carbuncle01/kart_bridge_board/docs/assets/generated/jpbb_rev2_top_render.png

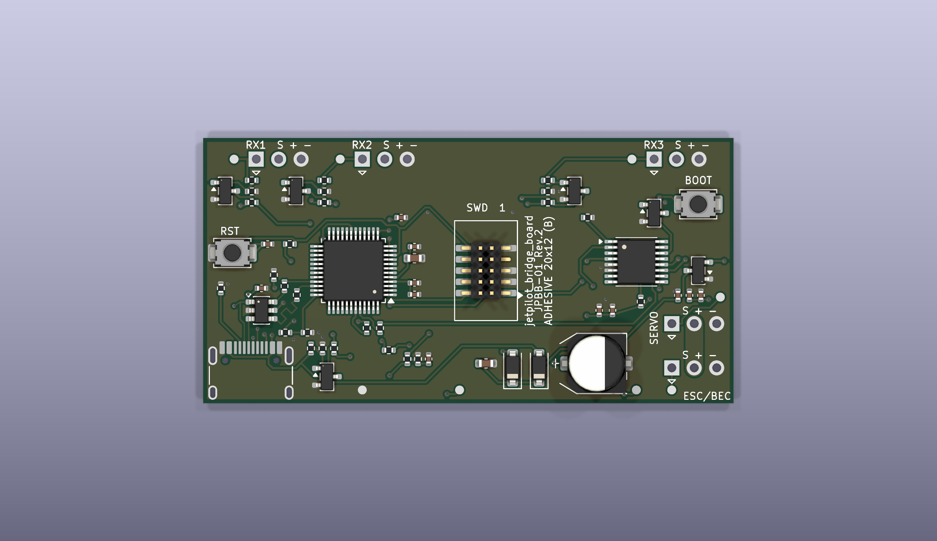
docs/assets/generated/jpbb_rev2_top_render.png
