carbuncle01/kart_bridge_board/docs/assets/jpbb_rev2_component_map.png

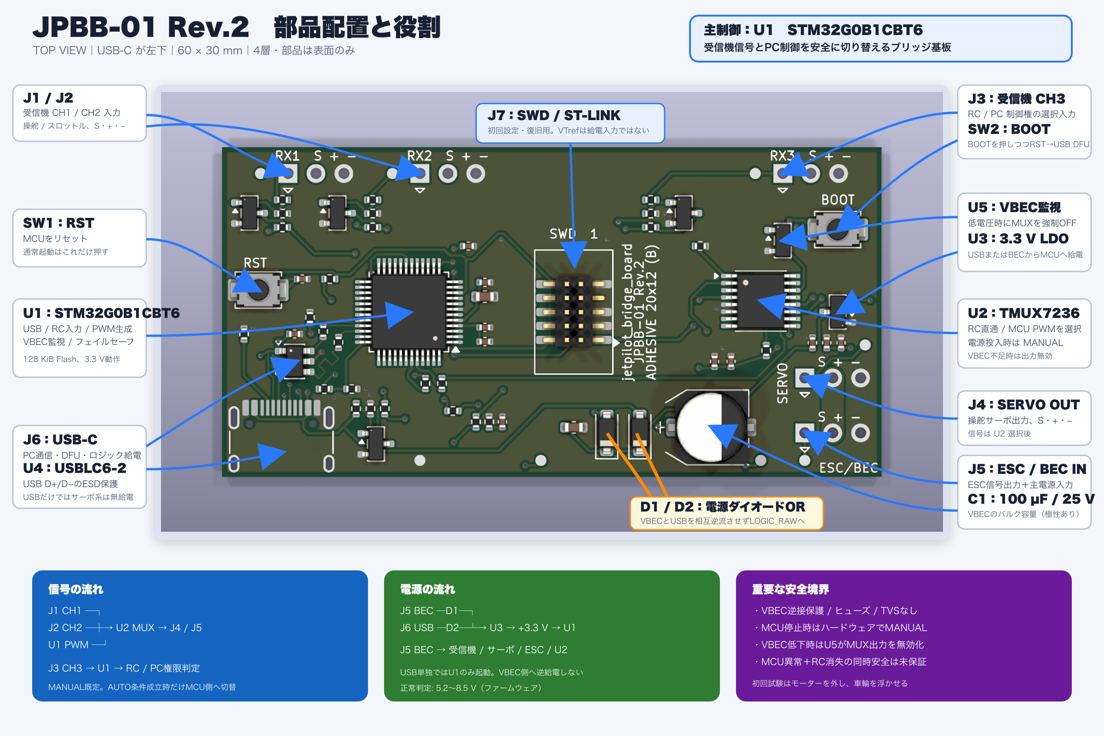
docs/assets/jpbb_rev2_component_map.png
