carbuncle01/kart_bridge_board/docs/assets/jpbb_rev2_testpoint_guide.png

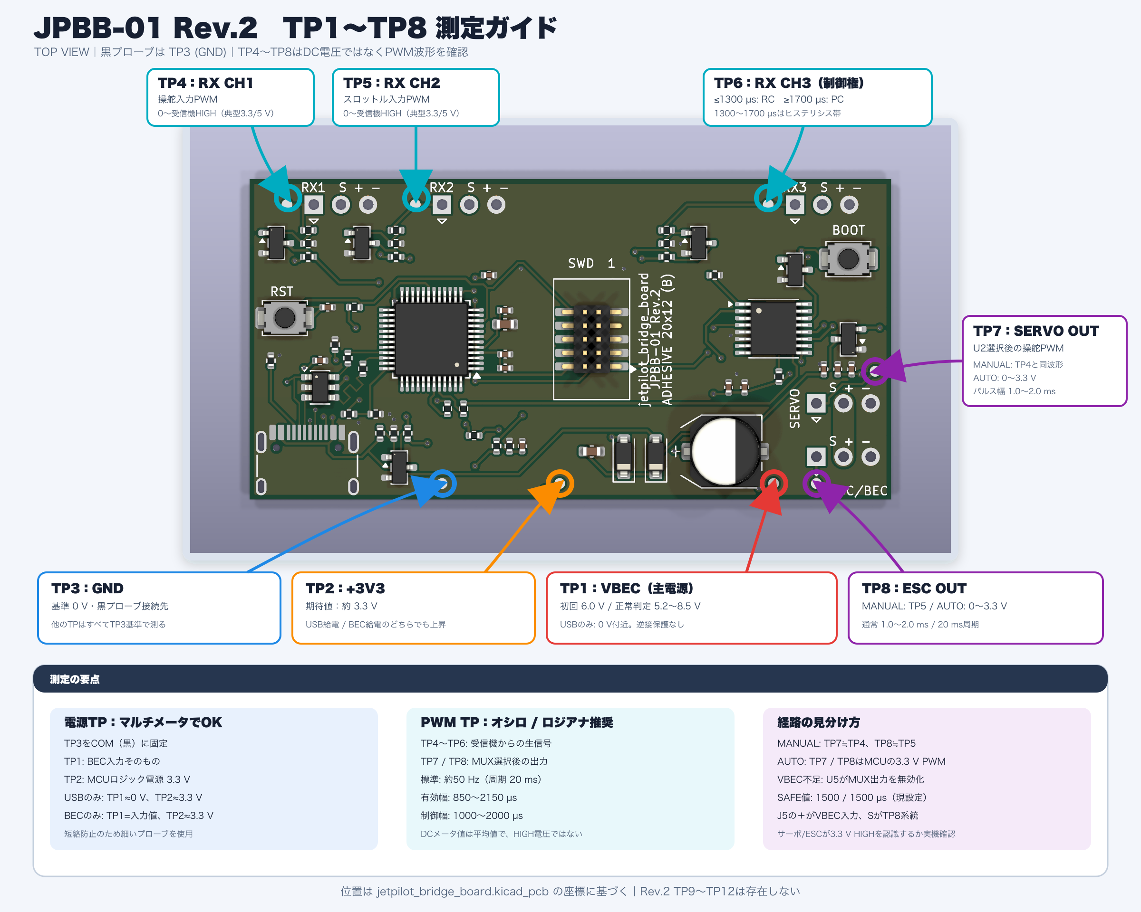
docs/assets/jpbb_rev2_testpoint_guide.png
