carbuncle01/kart_bridge_board/hardware/kicad/kart_bridge_board/kart_bridge_board.kicad_pcb

## KiCad design hardware/kicad/kart_bridge_board/kart_bridge_board.kicad_pcb (2026-10-04)

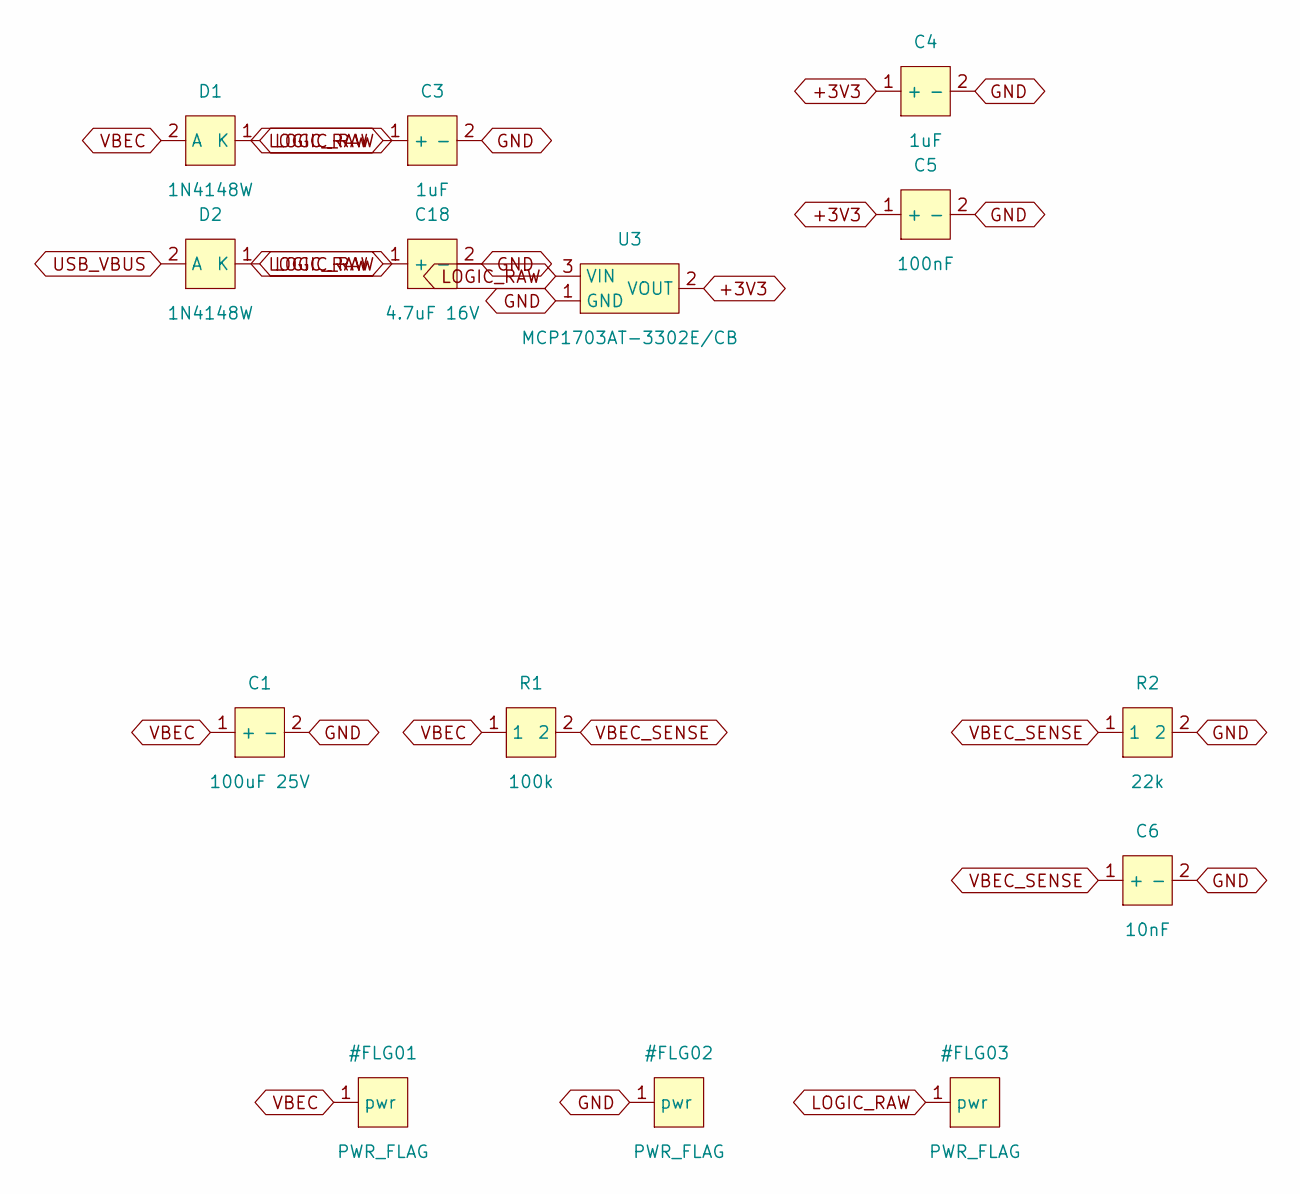
[picture p7: schematic 10_power.kicad_sch, kart_bridge_board — 10_power]

Parts:
C1: 100uF 25V; CP_Panasonic_D6.3x5.8; MPN EEHZK1E101UP; LCSC Part # C454668
C3, C4: 1uF; C_0402_1005Metric; MPN CL05A105KA5NQNC; LCSC Part # C52923
C5: 100nF; C_0402_1005Metric; MPN CL05B104KO5NNNC; LCSC Part # C1525
C6: 10nF; C_0402_1005Metric; MPN CL05B103KB5NNNC; LCSC Part # C15195
C18: 4.7uF 16V; C_0603_1608Metric; MPN CL10A475KO8NNNC; LCSC Part # C19666
D1, D2: 1N4148W; D_SOD-123; MPN 1N4148W; LCSC Part # C84367
R1: 100k; R_0402_1005Metric; MPN 0402WGF1003TCE; LCSC Part # C25741
R2: 22k; R_0402_1005Metric; MPN 0402WGF2202TCE; LCSC Part # C25768
U3: MCP1703AT-3302E/CB; SOT-23; MPN MCP1703AT-3302E/CB; LCSC Part # C144183

Connections:
+3V3: C4.1 (+), C5.1 (+), U3.2 (VOUT); also elsewhere on the board
GND: C1.2 (-), C3.2 (-), C4.2 (-), C5.2 (-), C6.2 (-), C18.2 (-), R2.2, U3.1 (GND); also elsewhere on the board
LOGIC_RAW: C3.1 (+), C18.1 (+), D1.1 (K), D2.1 (K), U3.3 (VIN)
USB_VBUS: D2.2 (A); also elsewhere on the board
VBEC: C1.1 (+), D1.2 (A), R1.1; also elsewhere on the board
VBEC_SENSE: C6.1 (+), R1.2, R2.1; also elsewhere on the board

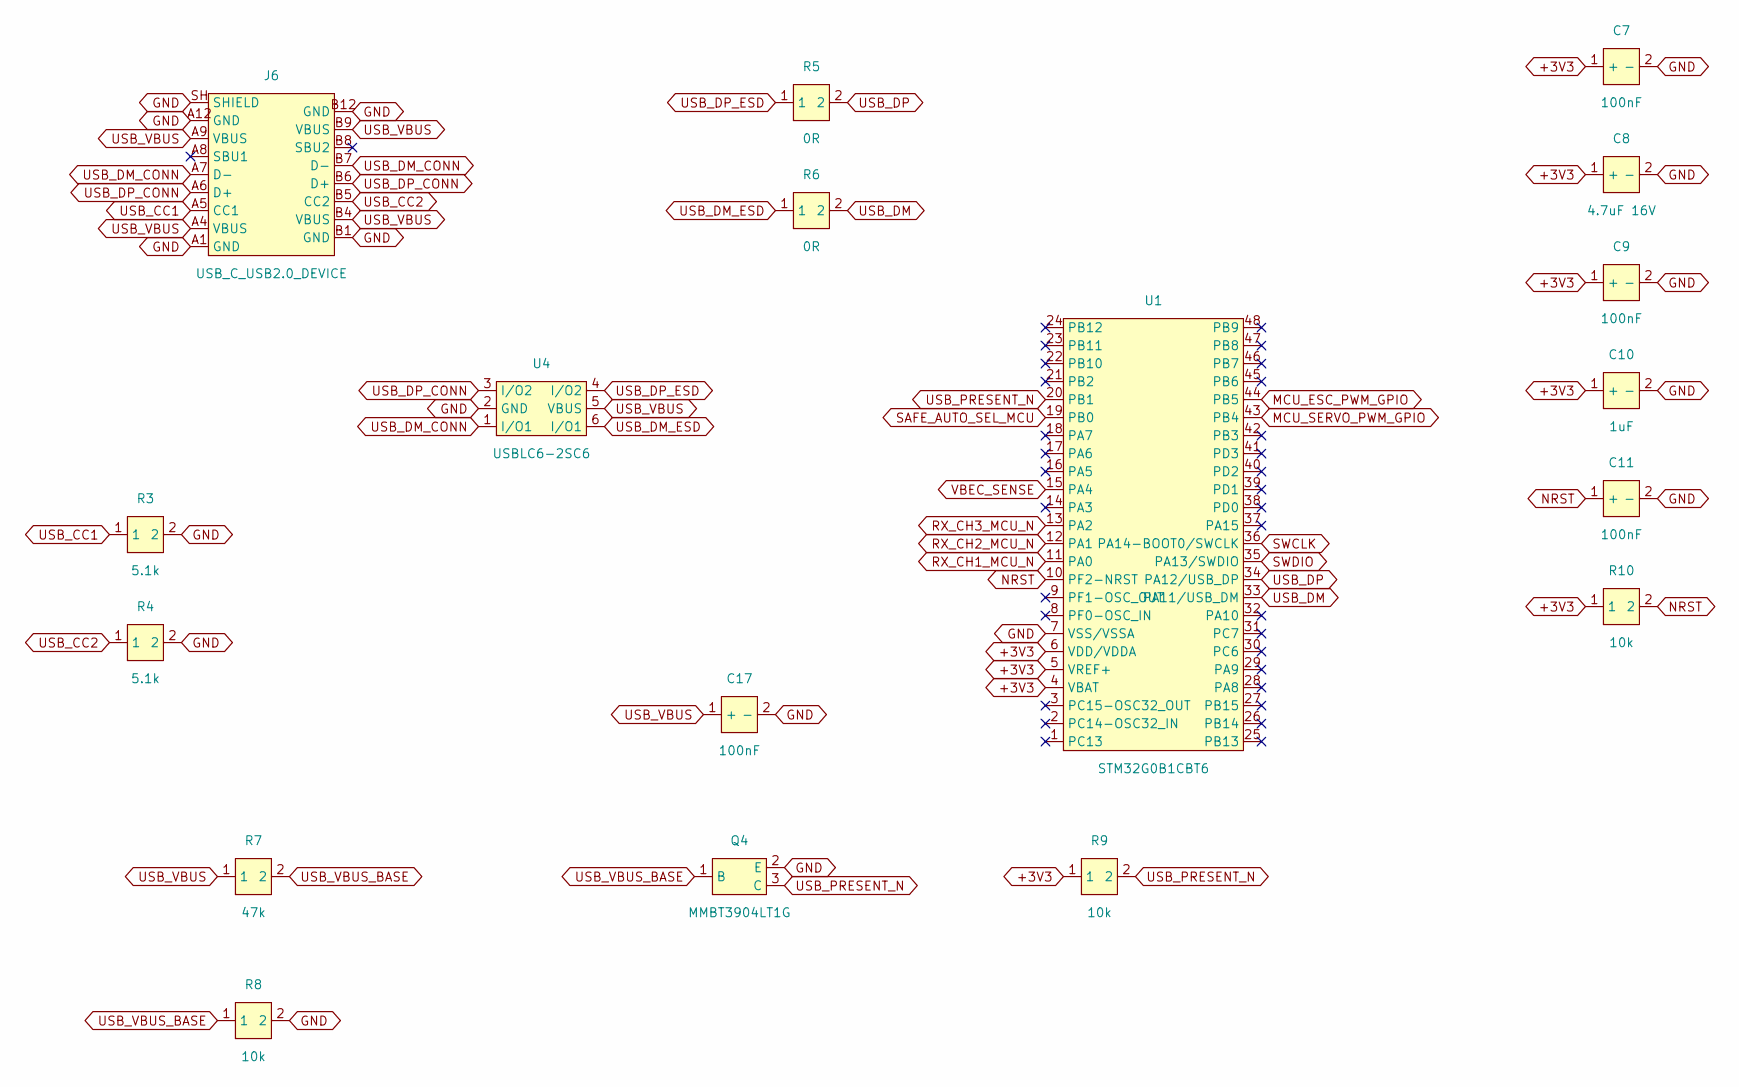
[picture p8: schematic 20_mcu_usb.kicad_sch, kart_bridge_board — 20_mcu_usb]

Parts:
C7, C9, C11, C17: 100nF; C_0402_1005Metric; MPN CL05B104KO5NNNC; LCSC Part # C1525
C8: 4.7uF 16V; C_0603_1608Metric; MPN CL10A475KO8NNNC; LCSC Part # C19666
C10: 1uF; C_0402_1005Metric; MPN CL05A105KA5NQNC; LCSC Part # C52923
J6: USB_C_USB2.0_DEVICE; USB_C_Receptacle_HRO_TYPE-C-31-M-12_Edge; MPN TYPE-C-31-M-12; LCSC Part # C165948
Q4: MMBT3904LT1G; SOT-23; MPN MMBT3904LT1G; LCSC Part # C81464
R3, R4: 5.1k; R_0402_1005Metric; MPN 0402WGF5101TCE; LCSC Part # C25905
R5, R6: 0R; R_0402_1005Metric; MPN 0402WGF0000TCE; LCSC Part # C17168
R7: 47k; R_0402_1005Metric; MPN 0402WGF4702TCE; LCSC Part # C25792
R8, R9, R10: 10k; R_0402_1005Metric; MPN 0402WGF1002TCE; LCSC Part # C25744
U1: STM32G0B1CBT6; LQFP-48_7x7mm_P0.5mm; MPN STM32G0B1CBT6; LCSC Part # C2847904
U4: USBLC6-2SC6; SOT-23-6; MPN USBLC6-2SC6; LCSC Part # C7519

Connections:
+3V3: C7.1 (+), C8.1 (+), C9.1 (+), C10.1 (+), R9.1, R10.1, U1.4 (VBAT), U1.5 (VREF+), U1.6 (VDD/VDDA); also elsewhere on the board
GND: C7.2 (-), C8.2 (-), C9.2 (-), C10.2 (-), C11.2 (-), C17.2 (-), J6.A1 (GND), J6.A12 (GND), J6.B1 (GND), J6.B12 (GND), J6.SH (SHIELD), Q4.2 (E), R3.2, R4.2, R8.2, U1.7 (VSS/VSSA), U4.2 (GND); also elsewhere on the board
MCU_ESC_PWM_GPIO: U1.44 (PB5); also elsewhere on the board
MCU_SERVO_PWM_GPIO: U1.43 (PB4); also elsewhere on the board
NRST: C11.1 (+), R10.2, U1.10 (PF2-NRST); also elsewhere on the board
RX_CH1_MCU_N: U1.11 (PA0); also elsewhere on the board
RX_CH2_MCU_N: U1.12 (PA1); also elsewhere on the board
RX_CH3_MCU_N: U1.13 (PA2); also elsewhere on the board
SAFE_AUTO_SEL_MCU: U1.19 (PB0); also elsewhere on the board
SWCLK: U1.36 (PA14-BOOT0/SWCLK); also elsewhere on the board
SWDIO: U1.35 (PA13/SWDIO); also elsewhere on the board
USB_CC1: J6.A5 (CC1), R3.1
USB_CC2: J6.B5 (CC2), R4.1
USB_DM: R6.2, U1.33 (PA11/USB_DM)
USB_DM_CONN: J6.A7 (D-), J6.B7 (D-), U4.1 (I/O1)
USB_DM_ESD: R6.1, U4.6 (I/O1)
USB_DP: R5.2, U1.34 (PA12/USB_DP)
USB_DP_CONN: J6.A6 (D+), J6.B6 (D+), U4.3 (I/O2)
USB_DP_ESD: R5.1, U4.4 (I/O2)
USB_PRESENT_N: Q4.3 (C), R9.2, U1.20 (PB1)
USB_VBUS: C17.1 (+), J6.A4 (VBUS), J6.A9 (VBUS), J6.B4 (VBUS), J6.B9 (VBUS), R7.1, U4.5 (VBUS); also elsewhere on the board
USB_VBUS_BASE: Q4.1 (B), R7.2, R8.1
VBEC_SENSE: U1.15 (PA4); also elsewhere on the board

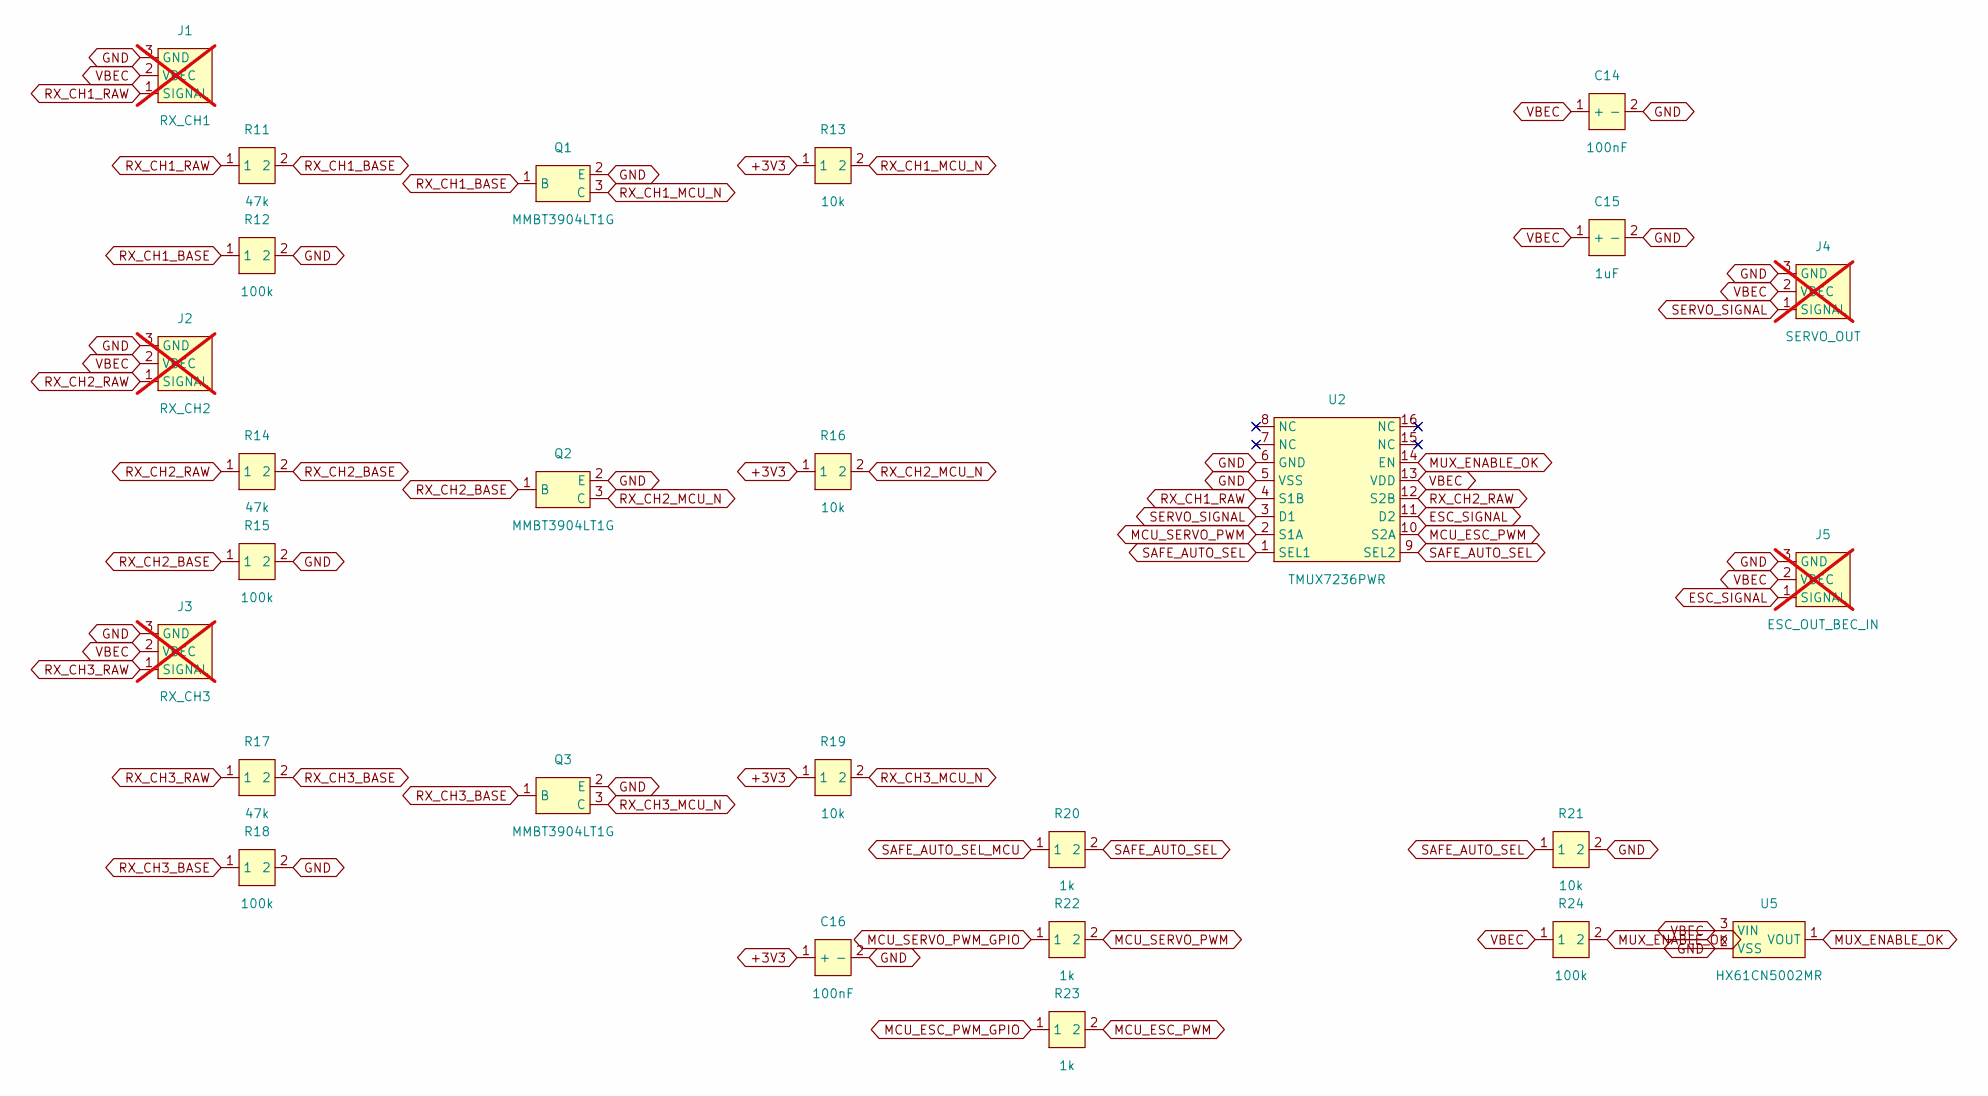
[picture p9: schematic 30_rc_mux.kicad_sch, kart_bridge_board — 30_rc_mux]

Parts:
C14, C16: 100nF; C_0402_1005Metric; MPN CL05B104KO5NNNC; LCSC Part # C1525
C15: 1uF; C_0402_1005Metric; MPN CL05A105KA5NQNC; LCSC Part # C52923
J1: RX_CH1; RC_Header_1x03_P2.54mm; MPN 2.54-1*3P Pin; not fitted
J2: RX_CH2; RC_Header_1x03_P2.54mm; MPN 2.54-1*3P Pin; not fitted
J3: RX_CH3; RC_Header_1x03_P2.54mm; MPN 2.54-1*3P Pin; not fitted
J4: SERVO_OUT; RC_Header_1x03_P2.54mm; MPN 2.54-1*3P Pin; not fitted
J5: ESC_OUT_BEC_IN; RC_Header_1x03_P2.54mm; MPN 2.54-1*3P Pin; not fitted
Q1, Q2, Q3: MMBT3904LT1G; SOT-23; MPN MMBT3904LT1G; LCSC Part # C81464
R11, R14, R17: 47k; R_0402_1005Metric; MPN 0402WGF4702TCE; LCSC Part # C25792
R12, R15, R18, R24: 100k; R_0402_1005Metric; MPN 0402WGF1003TCE; LCSC Part # C25741
R13, R16, R19, R21: 10k; R_0402_1005Metric; MPN 0402WGF1002TCE; LCSC Part # C25744
R20, R22, R23: 1k; R_0402_1005Metric; MPN 0402WGF1001TCE; LCSC Part # C11702
U2: TMUX7236PWR; TSSOP-16_4.4x5mm_P0.65mm; MPN TMUX7236PWR; LCSC Part # C37096021
U5: HX61CN5002MR; SOT-23; MPN HX61CN5002MR; LCSC Part # C47344213

Connections:
+3V3: C16.1 (+), R13.1, R16.1, R19.1; also elsewhere on the board
ESC_SIGNAL: J5.1 (SIGNAL), U2.11 (D2); also elsewhere on the board
GND: C14.2 (-), C15.2 (-), C16.2 (-), J1.3 (GND), J2.3 (GND), J3.3 (GND), J4.3 (GND), J5.3 (GND), Q1.2 (E), Q2.2 (E), Q3.2 (E), R12.2, R15.2, R18.2, R21.2, U2.5 (VSS), U2.6 (GND), U5.2 (VSS); also elsewhere on the board
MCU_ESC_PWM: R23.2, U2.10 (S2A)
MCU_ESC_PWM_GPIO: R23.1; also elsewhere on the board
MCU_SERVO_PWM: R22.2, U2.2 (S1A)
MCU_SERVO_PWM_GPIO: R22.1; also elsewhere on the board
MUX_ENABLE_OK: R24.2, U2.14 (EN), U5.1 (VOUT)
RX_CH1_BASE: Q1.1 (B), R11.2, R12.1
RX_CH1_MCU_N: Q1.3 (C), R13.2; also elsewhere on the board
RX_CH1_RAW: J1.1 (SIGNAL), R11.1, U2.4 (S1B); also elsewhere on the board
RX_CH2_BASE: Q2.1 (B), R14.2, R15.1
RX_CH2_MCU_N: Q2.3 (C), R16.2; also elsewhere on the board
RX_CH2_RAW: J2.1 (SIGNAL), R14.1, U2.12 (S2B); also elsewhere on the board
RX_CH3_BASE: Q3.1 (B), R17.2, R18.1
RX_CH3_MCU_N: Q3.3 (C), R19.2; also elsewhere on the board
RX_CH3_RAW: J3.1 (SIGNAL), R17.1; also elsewhere on the board
SAFE_AUTO_SEL: R20.2, R21.1, U2.1 (SEL1), U2.9 (SEL2)
SAFE_AUTO_SEL_MCU: R20.1; also elsewhere on the board
SERVO_SIGNAL: J4.1 (SIGNAL), U2.3 (D1); also elsewhere on the board
VBEC: C14.1 (+), C15.1 (+), J1.2 (VBEC), J2.2 (VBEC), J3.2 (VBEC), J4.2 (VBEC), J5.2 (VBEC), R24.1, U2.13 (VDD), U5.3 (VIN); also elsewhere on the board

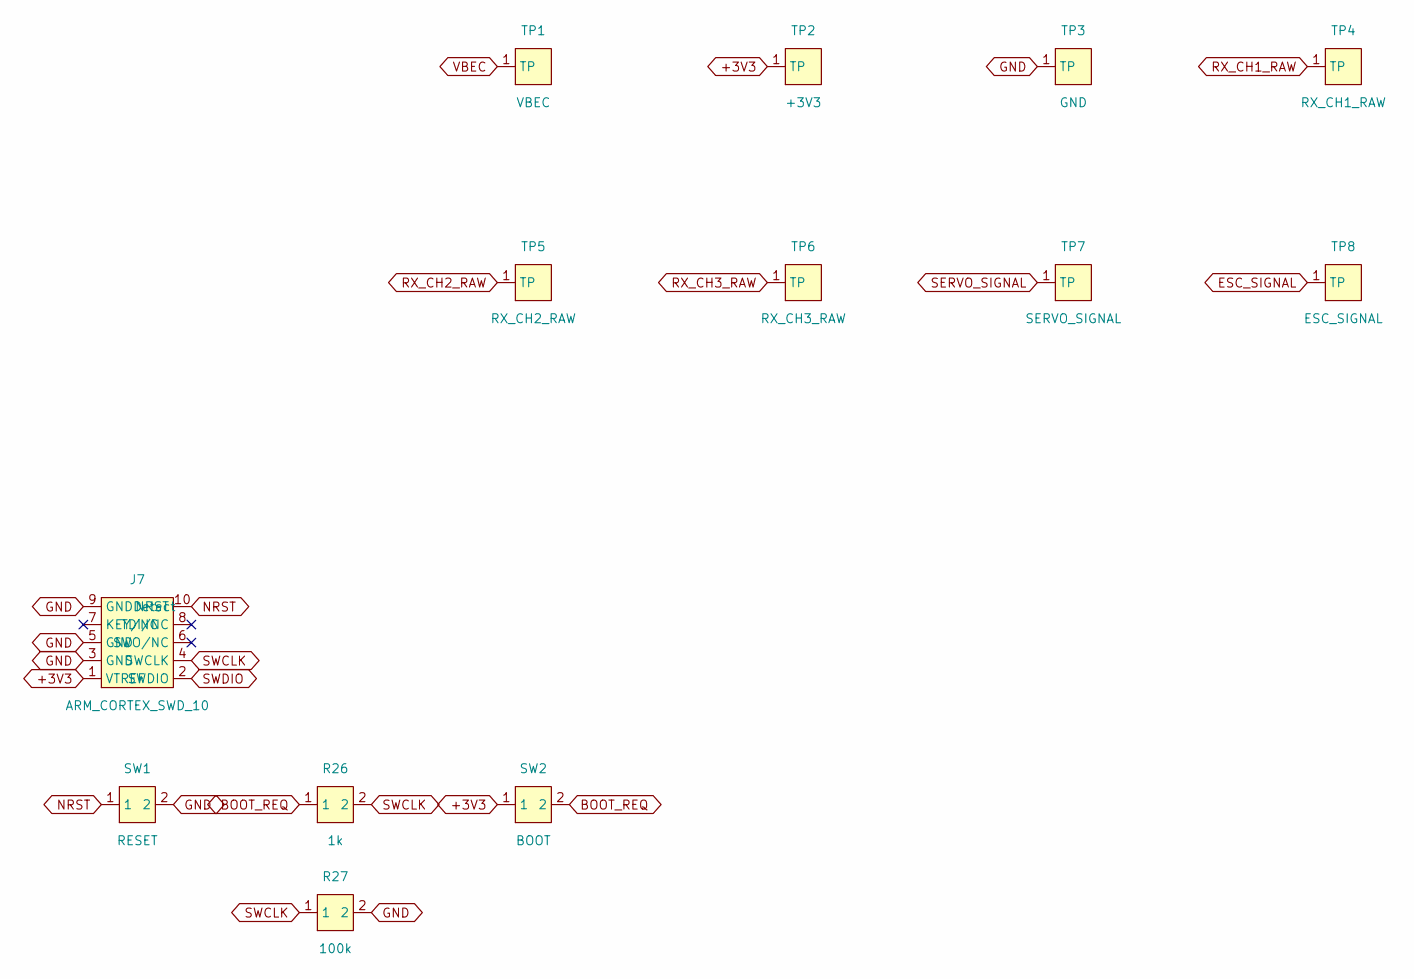
[picture p10: schematic 40_debug.kicad_sch, kart_bridge_board — 40_debug]

Parts:
J7: ARM_CORTEX_SWD_10; Samtec_FTSH-105-01-L-DV-007-K; MPN FTSH-105-01-L-DV-007-K; LCSC Part # C5296739
R26: 1k; R_0402_1005Metric; MPN 0402WGF1001TCE; LCSC Part # C11702
R27: 100k; R_0402_1005Metric; MPN 0402WGF1003TCE; LCSC Part # C25741
SW1: RESET; SW_SPST_TS-1088-xR020; MPN TS-1088-AR02016; LCSC Part # C720477
SW2: BOOT; SW_SPST_TS-1088-xR020; MPN TS-1088-AR02016; LCSC Part # C720477
TP1: VBEC; TP_SMD_D1.0mm
TP2: +3V3; TP_SMD_D1.0mm
TP3: GND; TP_SMD_D1.0mm
TP4: RX_CH1_RAW; TP_SMD_D1.0mm
TP5: RX_CH2_RAW; TP_SMD_D1.0mm
TP6: RX_CH3_RAW; TP_SMD_D1.0mm
TP7: SERVO_SIGNAL; TP_SMD_D1.0mm
TP8: ESC_SIGNAL; TP_SMD_D1.0mm

Connections:
+3V3: J7.1 (VTREF), SW2.1, TP2.1; also elsewhere on the board
BOOT_REQ: R26.1, SW2.2
ESC_SIGNAL: TP8.1; also elsewhere on the board
GND: J7.3 (GND), J7.5 (GND), J7.9 (GNDDetect), R27.2, SW1.2, TP3.1; also elsewhere on the board
NRST: J7.10 (NRST), SW1.1; also elsewhere on the board
RX_CH1_RAW: TP4.1; also elsewhere on the board
RX_CH2_RAW: TP5.1; also elsewhere on the board
RX_CH3_RAW: TP6.1; also elsewhere on the board
SERVO_SIGNAL: TP7.1; also elsewhere on the board
SWCLK: J7.4 (SWCLK), R26.2, R27.1; also elsewhere on the board
SWDIO: J7.2 (SWDIO); also elsewhere on the board
VBEC: TP1.1; also elsewhere on the board

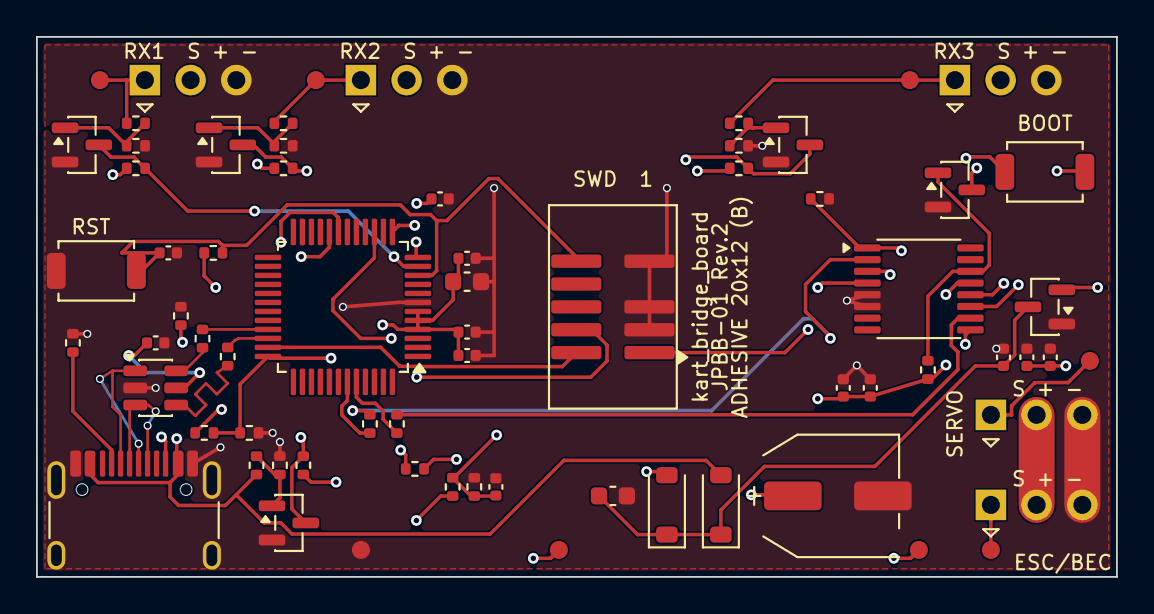
[picture p11: board kart_bridge_board.kicad_pcb from above]

Board: 4 copper layers, 60.0 x 30.0 mm, 69 parts (0 on the bottom side), 38 nets.
