carbuncle01/kart_bridge_board/hardware/kicad/kart_bridge_board/scripts/write_build_manifest.py

#!/usr/bin/env python3
"""Write immutable Rev.2 manufacturing metadata after every check passes."""

from __future__ import annotations

from pathlib import Path
import subprocess
import sys


def main() -> None:
    if len(sys.argv) != 3:
        raise SystemExit("usage: write_build_manifest.py OUTPUT KICAD_CLI")
    output = Path(sys.argv[1])
    kicad_cli = sys.argv[2]
    version = subprocess.run(
        [kicad_cli, "--version"], check=True, text=True,
        stdout=subprocess.PIPE,
    ).stdout.strip()
    lines = [
        "Project: kart_bridge_board",
        "Board ID: JPBB-01",
        "Revision: Rev.2",
        "Document ID: JPBB-HW-DEF-002",
        "Document date: 2026-07-23",
        f"KiCad: {version}",
        "Board: 60.0 x 30.0 mm, 4 layers, 1.0 mm",
        "Mounting: adhesive only; no H1/H2; B-side keepout 20.0 x 12.0 mm",
        "Assembly: Top side, 56 populated references; J1-J5 DNP",
        "Stack-up: standard 4-layer FR-4; vendor stack-up not specified",
        "Surface finish: Lead-free HASL",
        "Minimum finished via drill: 0.30 mm",
        "Controlled impedance: not specified (short USB Full-Speed routing)",
        "ERC: PASS (errors=0, warnings=0)",
        "DRC: PASS (errors=0, warnings=0, unconnected=0)",
        "Schematic netlist audit: PASS",
        "Schematic/PCB parity: PASS",
        "Independent PCB audit: PASS",
        "JLCPCB BOM/CPL validation: PASS",
    ]
    output.parent.mkdir(parents=True, exist_ok=True)
    output.write_text("\n".join(lines) + "\n", encoding="utf-8")


if __name__ == "__main__":
    main()
